danielzhang122/quadruped-robot/cad/quadruped-v1-urdf-source.png

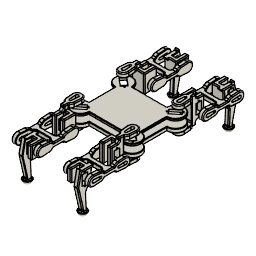
cad/quadruped-v1-urdf-source.png
