danielzhang122/quadruped-robot/description/meshes/bl_end.stl

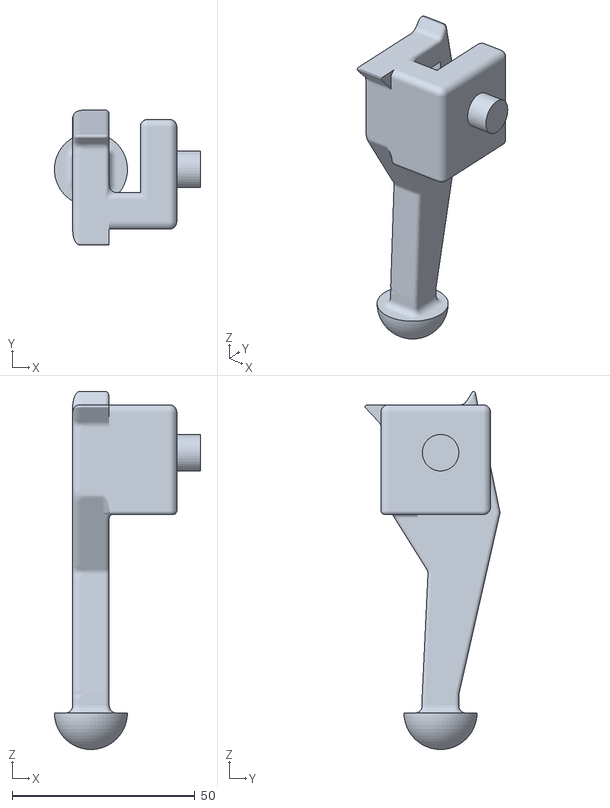
[picture p4: CAD file, 2026-11-11]
description/meshes/bl_end.stl
40.0 x 36.9 x 98.0
