danielzhang122/quadruped-robot/description/meshes/br_mid.stl

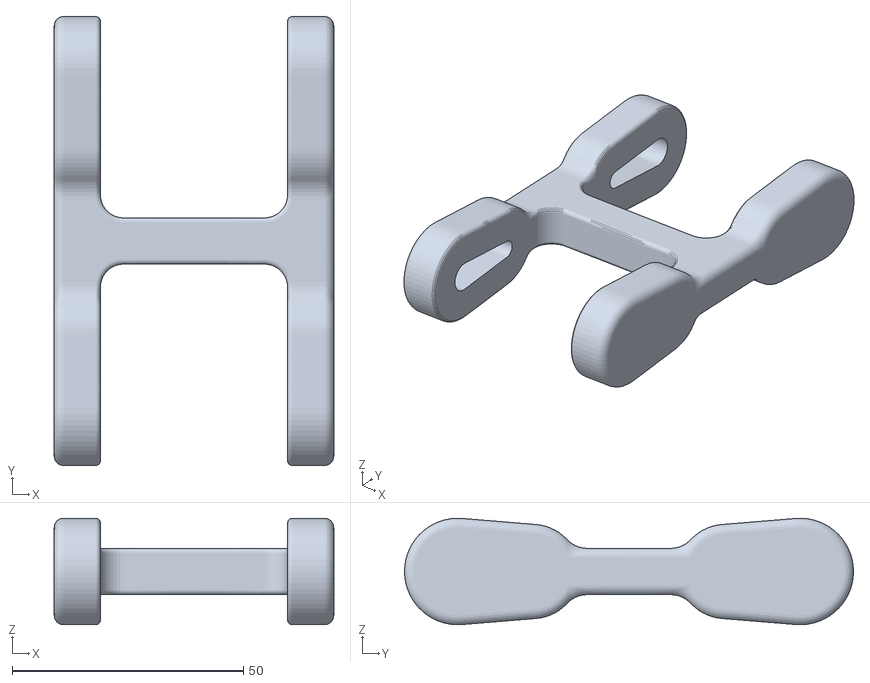
[picture p5: CAD file, 2026-11-11]
description/meshes/br_mid.stl
60.5 x 97.2 x 23.0
