danielzhang122/quadruped-robot/description/meshes/base_link.stl

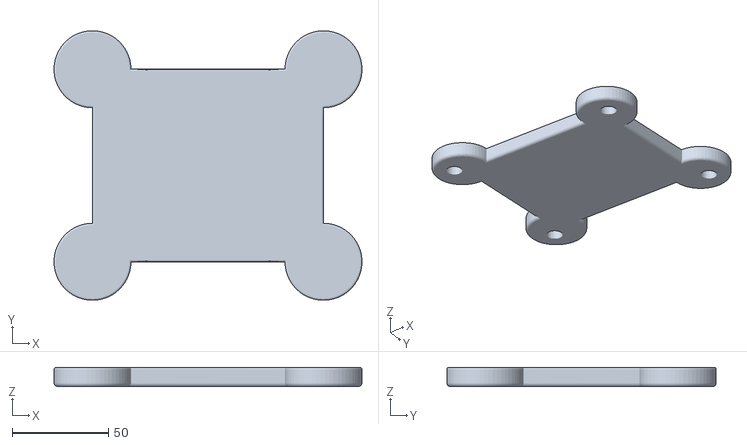
[picture p6: CAD file, 2026-11-11]
description/meshes/base_link.stl
160.0 x 140.0 x 10.0
