danielzhang122/quadruped-robot/description/meshes/fl_hip.stl

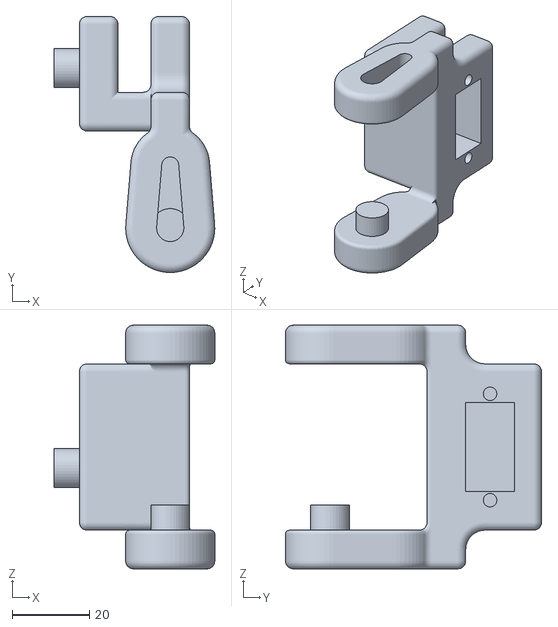
[picture p7: CAD file, 2026-11-11]
description/meshes/fl_hip.stl
41.5 x 66.2 x 63.0
