danielzhang122/quadruped-robot/description/meshes/base_upper.stl

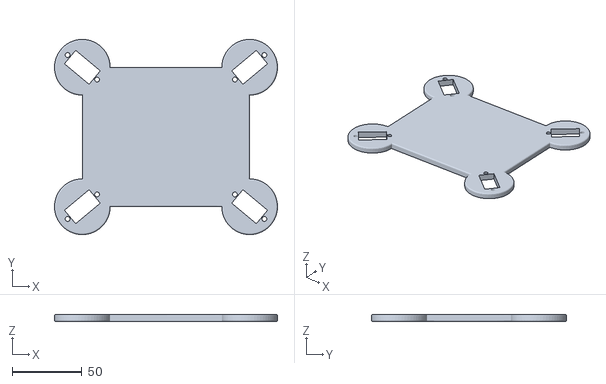
[picture p8: CAD file, 2026-11-11]
description/meshes/base_upper.stl
160.0 x 140.0 x 5.00
