danielzhang122/quadruped-robot/(list of files, cad)

Other CAD files:
description/meshes/fr_end.stl
description/meshes/fl_mid.stl
description/meshes/br_hip.stl
description/meshes/bl_hip.stl
description/meshes/br_end.stl
description/meshes/fr_mid.stl
description/meshes/fl_end.stl
description/meshes/fr_hip.stl
description/meshes/bl_mid.stl
cad/quadruped-v1-urdf-source.f3d
cad/quadruped-v2-may-2026.f3z
