danielzhang122/quadruped-robot/mujoco/robot.xml

<mujoco model="quadruped">
  <compiler angle="radian" meshdir="../description/meshes"/>

  <option gravity="0 0 -9.81" timestep="0.002"/>

  <default>
    <joint damping="1.5" frictionloss="0.2"/>
  </default>

  <asset>
    <mesh name="base_link" content_type="model/stl" file="base_link.stl" scale="0.001 0.001 0.001"/>
    <mesh name="fr_hip" content_type="model/stl" file="fr_hip.stl" scale="0.001 0.001 0.001"/>
    <mesh name="fr_mid" content_type="model/stl" file="fr_mid.stl" scale="0.001 0.001 0.001"/>
    <mesh name="fr_end" content_type="model/stl" file="fr_end.stl" scale="0.001 0.001 0.001"/>
    <mesh name="br_hip" content_type="model/stl" file="br_hip.stl" scale="0.001 0.001 0.001"/>
    <mesh name="br_mid" content_type="model/stl" file="br_mid.stl" scale="0.001 0.001 0.001"/>
    <mesh name="br_end" content_type="model/stl" file="br_end.stl" scale="0.001 0.001 0.001"/>
    <mesh name="fl_hip" content_type="model/stl" file="fl_hip.stl" scale="0.001 0.001 0.001"/>
    <mesh name="fl_mid" content_type="model/stl" file="fl_mid.stl" scale="0.001 0.001 0.001"/>
    <mesh name="fl_end" content_type="model/stl" file="fl_end.stl" scale="0.001 0.001 0.001"/>
    <mesh name="bl_hip" content_type="model/stl" file="bl_hip.stl" scale="0.001 0.001 0.001"/>
    <mesh name="bl_mid" content_type="model/stl" file="bl_mid.stl" scale="0.001 0.001 0.001"/>
    <mesh name="bl_end" content_type="model/stl" file="bl_end.stl" scale="0.001 0.001 0.001"/>
    <mesh name="base_upper" content_type="model/stl" file="base_upper.stl" scale="0.001 0.001 0.001"/>
  </asset>

  <worldbody>
    <light diffuse=".5 .5 .5" pos="0 0 3" dir="0 0 -1"/>
    <geom name="ground" type="plane" size="10 10 0.1" rgba="0.8 0.8 0.8 1"/>

    <body name="base_link" pos="0 0 0.15">
      <freejoint name="root"/>
      <geom type="mesh" mesh="base_link"/>
      <geom type="mesh" mesh="base_upper"/>

      <body name="fr_hip" pos="0.065762 -0.05514 -0.038083">
        <inertial pos="-0.00668492 -0.0276808 0.0119461" quat="0.965743 0.207359 -0.0300658 -0.153095" mass="0.0441843" diaginertia="2.99304e-05 1.92258e-05 1.66333e-05"/>
        <joint name="frontRightHip" pos="0 0 0" axis="0 0 -1" range="-2.35619 0.785398" actuatorfrcrange="-100 100"/>
        <geom pos="-0.065762 0.05514 0.038083" type="mesh" mesh="fr_hip"/>
        <body name="fr_mid" pos="-0.03 -0.041341 0.00755">
          <inertial pos="0.0243043 -0.0370653 -3.7597e-07" quat="0.5 0.5 -0.5 0.5" mass="0.0356783" diaginertia="4.69872e-05 2.72823e-05 2.18994e-05"/>
          <joint name="frontRightMid" pos="0 0 0" axis="-1 0 0" range="-1.5708 1.5708" actuatorfrcrange="-100 100"/>
          <geom pos="-0.035762 0.096481 0.030533" type="mesh" mesh="fr_mid"/>
          <body name="fr_end" pos="-0.002 -0.074131 0">
            <inertial pos="0.0248621 0.00119021 -0.0180069" quat="0.994646 -0.0397935 -0.0924563 0.0233996" mass="0.0299344" diaginertia="2.27975e-05 2.27196e-05 3.89009e-06"/>
            <joint name="frontRightEnd" pos="0 0 0" axis="1 0 0" range="-3.14159 0" actuatorfrcrange="-100 100"/>
            <geom pos="-0.033762 0.170612 0.030533" type="mesh" mesh="fr_end"/>
          </body>
        </body>
      </body>

      <body name="br_hip" pos="-0.062496 -0.05514 -0.038083">
        <inertial pos="0.00668428 -0.0276808 0.0119461" quat="0.965744 0.207356 0.0300641 0.153096" mass="0.0441844" diaginertia="2.99305e-05 1.92258e-05 1.66333e-05"/>
        <joint name="backRightHip" pos="0 0 0" axis="0 0 -1" range="-0.785398 2.35619" actuatorfrcrange="-100 100"/>
        <geom pos="0.062496 0.05514 0.038083" type="mesh" mesh="br_hip"/>
        <body name="br_mid" pos="0.03 -0.041341 0.00755">
          <inertial pos="-0.024305 -0.0370653 -3.75428e-07" quat="0.5 0.5 -0.5 0.5" mass="0.0356783" diaginertia="4.69872e-05 2.72823e-05 2.18995e-05"/>
          <joint name="backRightMid" pos="0 0 0" axis="1 0 0" range="-1.5708 1.5708" actuatorfrcrange="-100 100"/>
          <geom pos="0.032496 0.096481 0.030533" type="mesh" mesh="br_mid"/>
          <body name="br_end" pos="0.002 -0.074131 0">
            <inertial pos="-0.0248627 0.00119021 -0.0180069" quat="0.994646 -0.0397935 0.0924563 -0.0233996" mass="0.0299344" diaginertia="2.27975e-05 2.27196e-05 3.89009e-06"/>
            <joint name="backRightEnd" pos="0 0 0" axis="-1 0 0" range="0 3.14159" actuatorfrcrange="-100 100"/>
            <geom pos="0.030496 0.170612 0.030533" type="mesh" mesh="br_end"/>
          </body>
        </body>
      </body>

      <body name="fl_hip" pos="0.065762 0.051742 -0.038083">
        <inertial pos="-0.0066849 0.02768 0.0119461" quat="0.965744 -0.207356 -0.0300641 0.153096" mass="0.0441844" diaginertia="2.99305e-05 1.92258e-05 1.66333e-05"/>
        <joint name="frontLeftHip" pos="0 0 0" axis="0 0 -1" range="-0.785398 2.35619" actuatorfrcrange="-100 100"/>
        <geom pos="-0.065762 -0.051742 0.038083" type="mesh" mesh="fl_hip"/>
        <body name="fl_mid" pos="-0.03 0.04134 0.00755">
          <inertial pos="0.0243043 0.0370655 -3.75428e-07" quat="0.5 0.5 -0.5 0.5" mass="0.0356783" diaginertia="4.69872e-05 2.72823e-05 2.18995e-05"/>
          <joint name="frontLeftMid" pos="0 0 0" axis="-1 0 0" range="-1.5708 1.5708" actuatorfrcrange="-100 100"/>
          <geom pos="-0.035762 -0.093082 0.030533" type="mesh" mesh="fl_mid"/>
          <body name="fl_end" pos="-0.002 0.074131 0">
            <inertial pos="0.0248621 -0.00118998 -0.0180069" quat="0.994646 0.0397935 -0.0924563 -0.0233996" mass="0.0299344" diaginertia="2.27975e-05 2.27196e-05 3.89009e-06"/>
            <joint name="frontLeftEnd" pos="0 0 0" axis="1 0 0" range="0 3.14159" actuatorfrcrange="-100 100"/>
            <geom pos="-0.033762 -0.167213 0.030533" type="mesh" mesh="fl_end"/>
          </body>
        </body>
      </body>

      <body name="bl_hip" pos="-0.062496 0.051742 -0.038083">
        <inertial pos="0.00668431 0.02768 0.0119461" quat="0.965743 -0.207359 0.0300658 -0.153095" mass="0.0441843" diaginertia="2.99304e-05 1.92258e-05 1.66333e-05"/>
        <joint name="backLeftHip" pos="0 0 0" axis="0 0 -1" range="-2.35619 0.785398" actuatorfrcrange="-100 100"/>
        <geom pos="0.062496 -0.051742 0.038083" type="mesh" mesh="bl_hip"/>
        <body name="bl_mid" pos="0.03 0.04134 0.00755">
          <inertial pos="-0.024305 0.0370655 -3.7597e-07" quat="0.5 0.5 -0.5 0.5" mass="0.0356783" diaginertia="4.69872e-05 2.72823e-05 2.18994e-05"/>
          <joint name="backLeftMid" pos="0 0 0" axis="1 0 0" range="-1.5708 1.5708" actuatorfrcrange="-100 100"/>
          <geom pos="0.032496 -0.093082 0.030533" type="mesh" mesh="bl_mid"/>
          <body name="bl_end" pos="0.002 0.074131 0">
            <inertial pos="-0.0248627 -0.00118998 -0.0180069" quat="0.994646 0.0397935 0.0924563 0.0233996" mass="0.0299344" diaginertia="2.27975e-05 2.27196e-05 3.89009e-06"/>
            <joint name="backLeftEnd" pos="0 0 0" axis="-1 0 0" range="-3.14159 0" actuatorfrcrange="-100 100"/>
            <geom pos="0.030496 -0.167213 0.030533" type="mesh" mesh="bl_end"/>
          </body>
        </body>
      </body>

    </body>
  </worldbody>

  <actuator>
    <position name="frontRightHip" joint="frontRightHip" kp="100" ctrlrange="-2.356 0.785"/>
    <position name="frontRightMid" joint="frontRightMid" kp="100" ctrlrange="-1.571 1.571"/>
    <position name="frontRightEnd" joint="frontRightEnd" kp="100" ctrlrange="-3.142 0.0"/>
    <position name="backRightHip" joint="backRightHip" kp="100" ctrlrange="-0.785 2.356"/>
    <position name="backRightMid" joint="backRightMid" kp="100" ctrlrange="-1.571 1.571"/>
    <position name="backRightEnd" joint="backRightEnd" kp="100" ctrlrange="0.0 3.142"/>
    <position name="frontLeftHip" joint="frontLeftHip" kp="100" ctrlrange="-0.785 2.356"/>
    <position name="frontLeftMid" joint="frontLeftMid" kp="100" ctrlrange="-1.571 1.571"/>
    <position name="frontLeftEnd" joint="frontLeftEnd" kp="100" ctrlrange="0.0 3.142"/>
    <position name="backLeftHip" joint="backLeftHip" kp="100" ctrlrange="-2.356 0.785"/>
    <position name="backLeftMid" joint="backLeftMid" kp="100" ctrlrange="-1.571 1.571"/>
    <position name="backLeftEnd" joint="backLeftEnd" kp="100" ctrlrange="-3.142 0.0"/>
  </actuator>

</mujoco>
