danielzhang122/quadruped-robot/pcb/quadped.kicad_pcb

## KiCad design pcb/quadped.kicad_pcb (2026-11-12)

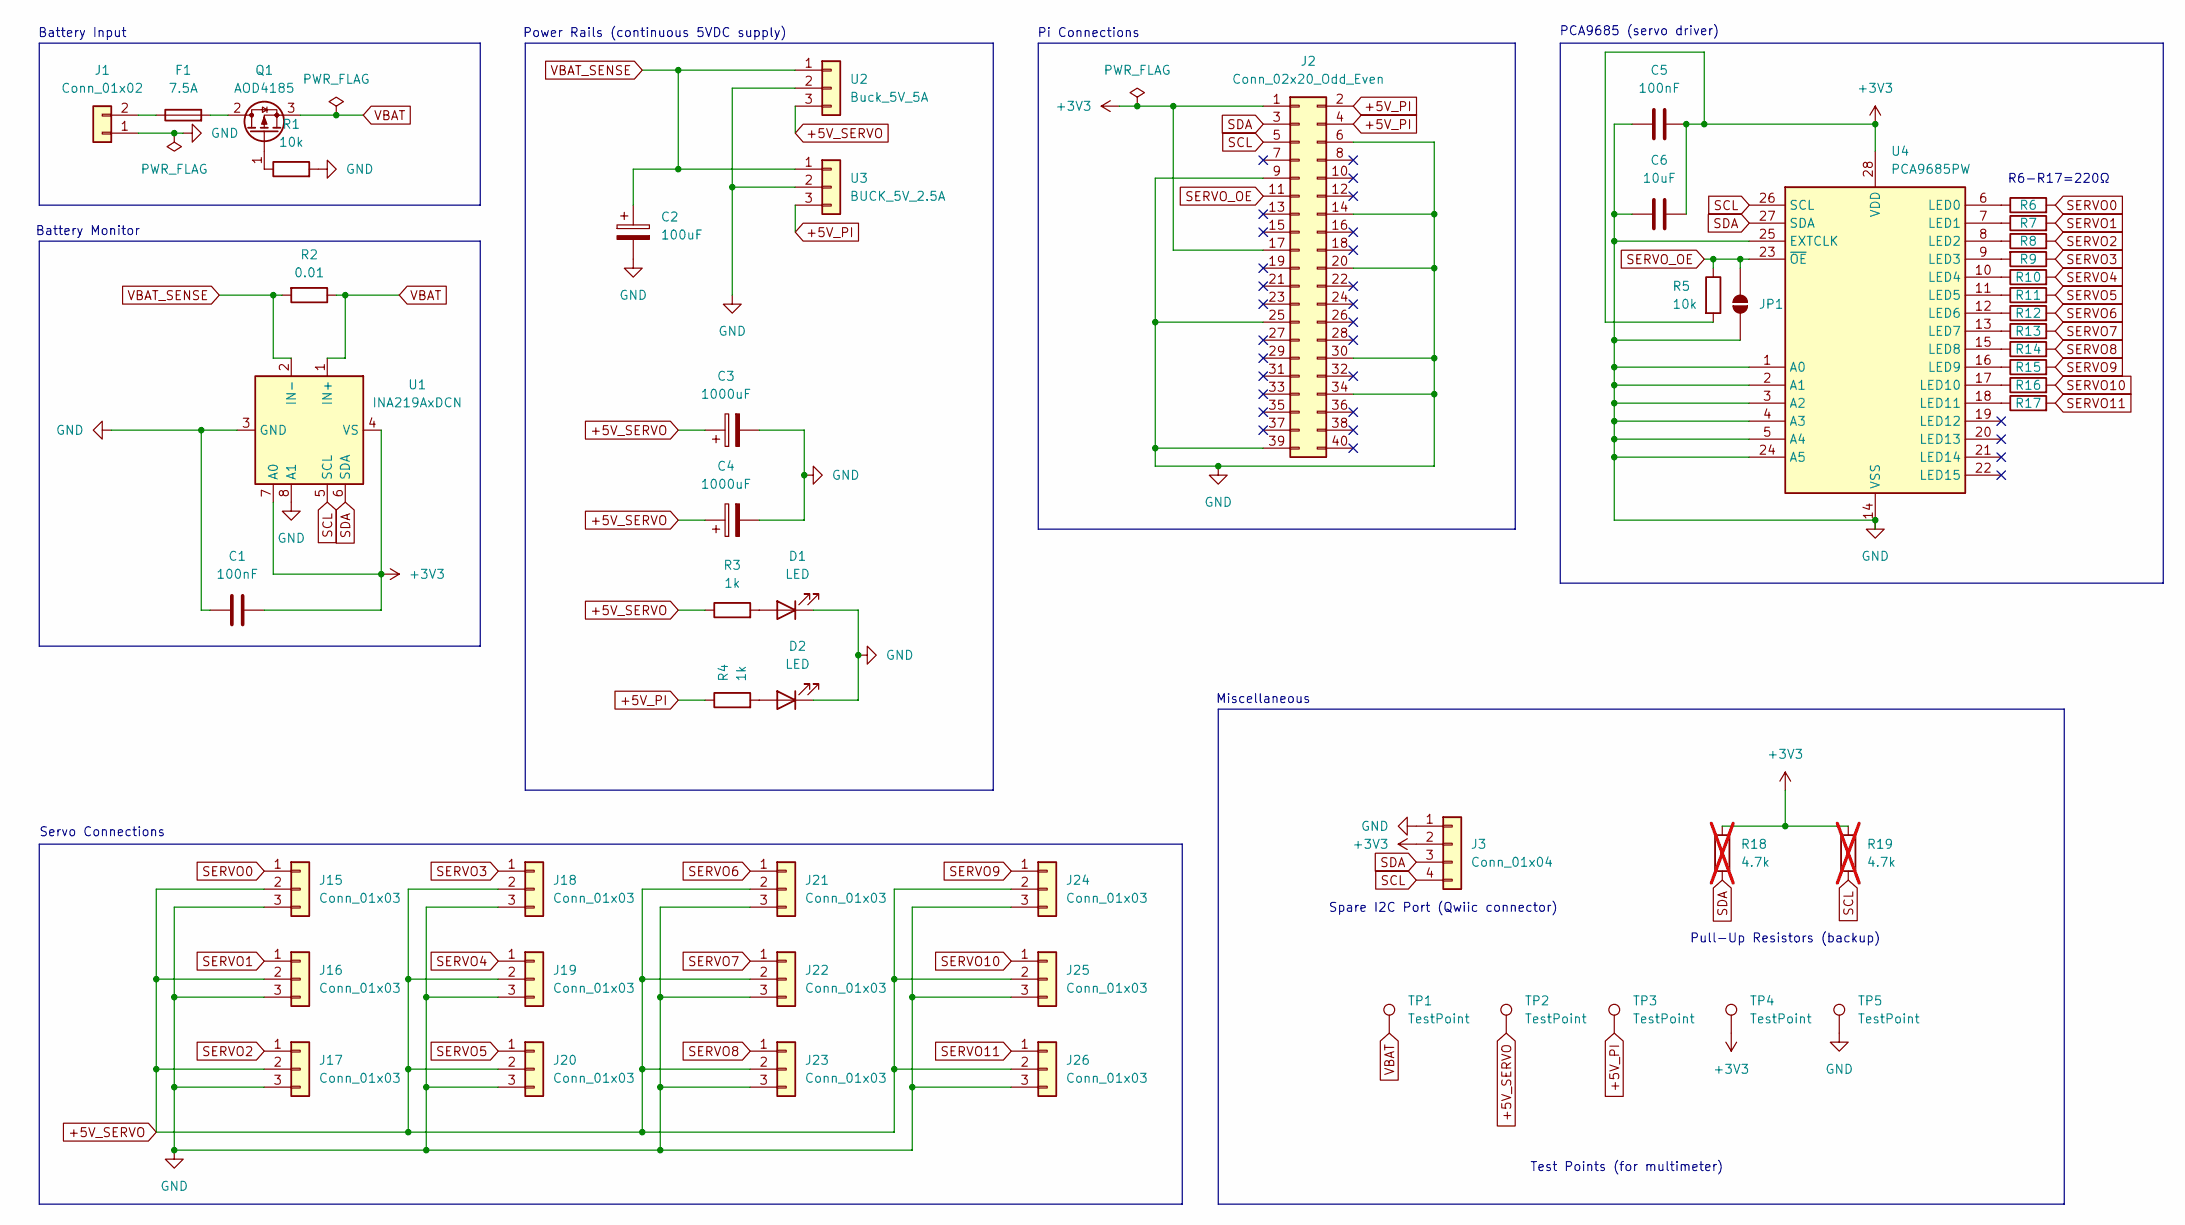
[picture p9: schematic quadped.kicad_sch, Main PCB]

Parts:
C1, C5: 100nF; C_0805_2012Metric
C2: 100uF; CP_Radial_D6.3mm_P2.50mm
C3, C4: 1000uF; CP_Radial_D10.0mm_P5.00mm
C6: 10uF; C_0805_2012Metric
D1, D2: LED; LED_0805_2012Metric
F1: 7.5A; Fuseholder_Blade_Mini_Keystone_3568
J1: Conn_01x02; AMASS_XT30PW-M_1x02_P2.50mm_Horizontal
J2: Conn_02x20_Odd_Even; PinHeader_2x20_P2.54mm_Vertical
J3: Conn_01x04; JST_SH_SM04B-SRSS-TB_1x04-1MP_P1.00mm_Horizontal
J15, J16, J17, J18, J19, J20, J21, J22, J23, J24, J25, J26: Conn_01x03; PinHeader_1x03_P2.54mm_Vertical
JP1: BYPASS; SolderJumper-2_P1.3mm_Open_Pad1.0x1.5mm
Q1: AOD4185; TO-252-2
R1, R5: 10k; R_0805_2012Metric
R2: 0.01; R_2512_6332Metric
R3, R4: 1k; R_0805_2012Metric
R6, R7, R8, R9, R10, R11, R12, R13, R14, R15, R16, R17: 220; R_0805_2012Metric
R18, R19: 4.7k; R_0805_2012Metric; not fitted
TP1, TP2, TP3, TP4, TP5: TestPoint; TestPoint_Pad_D1.5mm
U1: INA219AxDCN; SOT-23-8
U2: Buck_5V_5A; PinHeader_1x03_P2.54mm_Vertical
U3: BUCK_5V_2.5A; PinHeader_1x03_P2.54mm_Vertical
U4: PCA9685PW; TSSOP-28_4.4x9.7mm_P0.65mm

Connections:
+3V3: C1.2, C5.2, C6.2, J2.1, J2.17, J3.2, R5.2, R18.2, R19.1, TP4.1 (1_1), U1.4 (VS), U1.7 (A0), U4.28 (VDD)
+5V_PI: J2.2, J2.4, R4.1, TP3.1 (1_1), U3.3
+5V_SERVO: C3.1, C4.1, J15.2, J16.2, J17.2, J18.2, J19.2, J20.2, J21.2, J22.2, J23.2, J24.2, J25.2, J26.2, R3.1, TP2.1 (1_1), U2.3
GND: C1.1, C2.2, C3.2, C4.2, C5.1, C6.1, D1.1 (K), D2.1 (K), J1.1, J2.6, J2.9, J2.14, J2.20, J2.25, J2.30, J2.34, J2.39, J3.1, J15.3, J16.3, J17.3, J18.3, J19.3, J20.3, J21.3, J22.3, J23.3, J24.3, J25.3, J26.3, JP1.1 (A), R1.2, TP5.1 (1_1), U1.3 (GND), U1.8 (A1), U2.2, U3.2, U4.1 (A0), U4.2 (A1), U4.3 (A2), U4.4 (A3), U4.5 (A4), U4.14 (VSS), U4.24 (A5), U4.25 (EXTCLK)
unnamed: D1.2 (A), R3.2
unnamed: D2.2 (A), R4.2
unnamed: F1.1, J1.2
unnamed: F1.2, Q1.2 (D)
unnamed: Q1.1 (G), R1.1
unnamed: R6.1, U4.6 (LED0)
unnamed: R7.1, U4.7 (LED1)
unnamed: R8.1, U4.8 (LED2)
unnamed: R9.2, U4.9 (LED3)
unnamed: R10.1, U4.10 (LED4)
unnamed: R11.1, U4.11 (LED5)
unnamed: R12.1, U4.12 (LED6)
unnamed: R13.1, U4.13 (LED7)
unnamed: R14.1, U4.15 (LED8)
unnamed: R15.1, U4.16 (LED9)
unnamed: R16.1, U4.17 (LED10)
unnamed: R17.1, U4.18 (LED11)
SCL: J2.5, J3.4, R19.2, U1.5 (SCL), U4.26 (SCL)
SDA: J2.3, J3.3, R18.1, U1.6 (SDA), U4.27 (SDA)
SERVO0: J15.1, R6.2
SERVO1: J16.1, R7.2
SERVO2: J17.1, R8.2
SERVO3: J18.1, R9.1
SERVO4: J19.1, R10.2
SERVO5: J20.1, R11.2
SERVO6: J21.1, R12.2
SERVO7: J22.1, R13.2
SERVO8: J23.1, R14.2
SERVO9: J24.1, R15.2
SERVO10: J25.1, R16.2
SERVO11: J26.1, R17.2
SERVO_OE: J2.11, JP1.2 (B), R5.1, U4.23 (~OE)
VBAT: Q1.3 (S), R2.1, TP1.1 (1_1), U1.1 (IN+)
VBAT_SENSE: C2.1, R2.2, U1.2 (IN-), U2.1, U3.1

Notes on the sheet:
PCA9685 (servo driver)
Pi Connections
Battery Input
Test Points (for multimeter)
Spare I2C Port (Qwiic connector)
Power Rails (continuous 5VDC supply)
R6-R17=220Ω
Battery Monitor
Miscellaneous
Pull-Up Resistors (backup)
Servo Connections

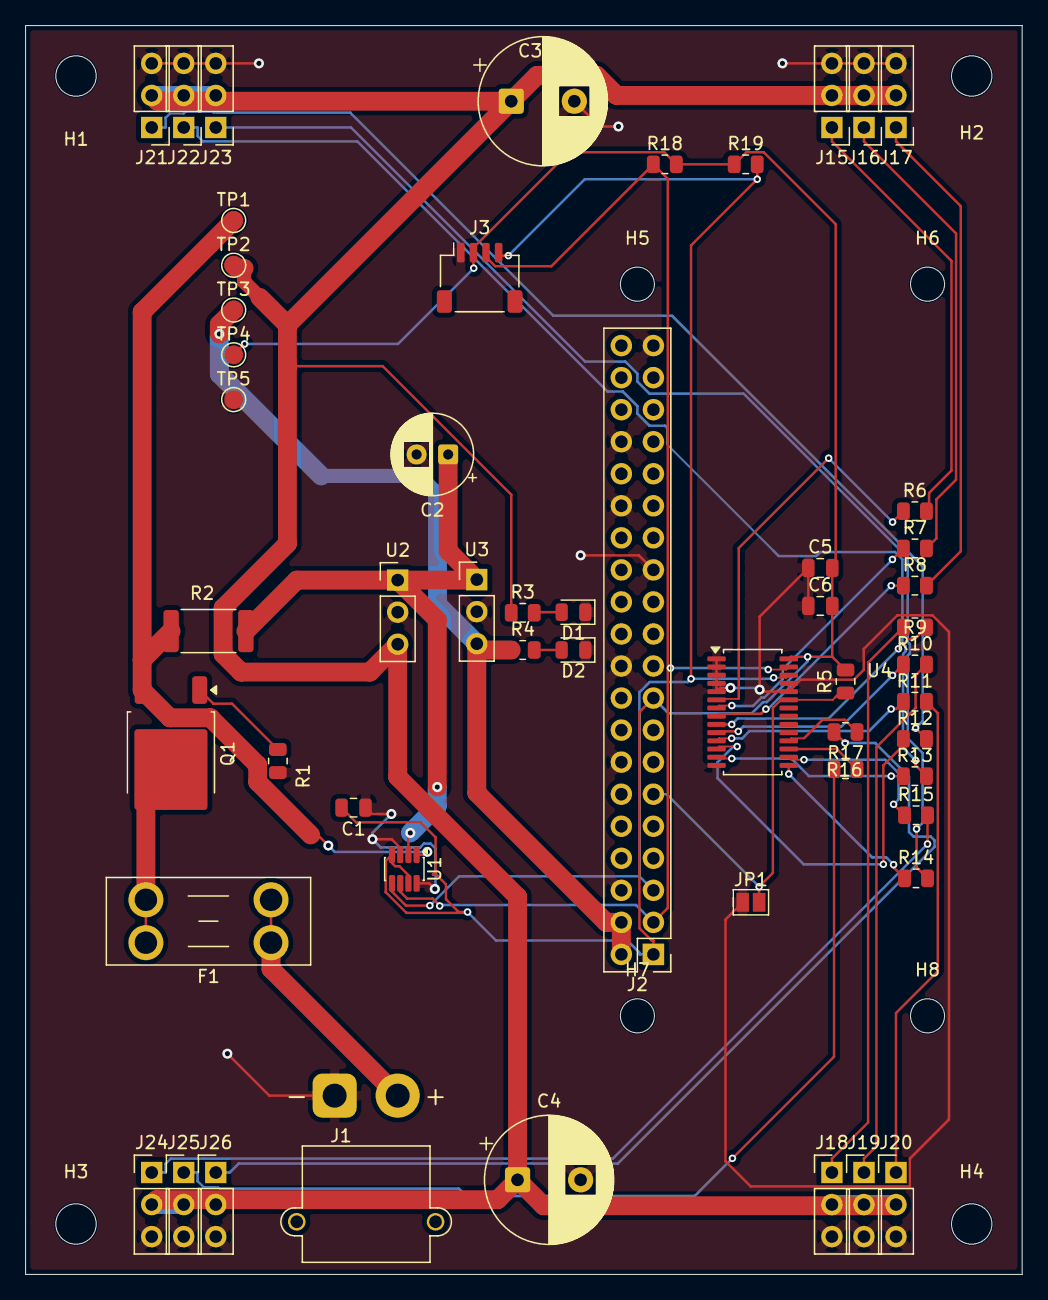
[picture p10: board quadped.kicad_pcb from above]

Board: 2 copper layers, 79.0 x 99.0 mm, 62 parts (0 on the bottom side), 38 nets.

Other parts of the board:
H1, H2, H3, H4: MountingHole_3.2mm_M3
H5, H6, H7, H8: MountingHole_2.7mm_M2.5
