danielzhang122/quadruped-robot/(commit log)

2026-11-11 Initial commit: quadruped trot controller, MuJoCo model, URDF and CAD
    - Trot gait controller (sim + PCA9685 hardware) with fixed joint frame,
    working --hardware flag, and I2C write deadband on hardware
    - MuJoCo model, ROS 2 quadruped_description package, STL meshes renamed
    to a consistent <leg>_<segment> scheme
    - CAD: v2 (May 2026, latest, .f3z) and v1 (URDF source)
    - Unit, hardware-mapping and headless sim tests
    [base_link.stl, base_upper.stl, bl_end.stl, bl_hip.stl, bl_mid.stl, br_end.stl, br_hip.stl, br_mid.stl]
2026-11-11 Document hardware readiness, CAD components, and portfolio link
2026-11-11 Add PCB plan and KiCad guide
    Covers the board's circuit (battery input, two 5 V rails, PCA9685, INA219, Pi header, servo headers), KiCad workflow, BOM and bring-up.
2026-11-11 Add full PCB component list, net names and board layout
2026-11-11 Explain each PCB section and part in the README
2026-11-11 Match J1 pinout to schematic (pin 1 = +)
2026-11-11 Explain I2C addresses in PCB section 2
2026-11-11 Clarify INA219 address is picked by A0/A1 wiring
2026-11-11 Explain footprints and match part refs to schematic
2026-11-11 Add KiCad project: complete schematic with footprints
    [quadped.kicad_pcb, quadped.kicad_sch]
2026-11-11 Match J1 pinout to XT30 footprint (pin 2 = +)
2026-11-11 Move KiCad project files up into pcb/
    [quadped.kicad_pcb, quadped.kicad_sch]
2026-11-11 Update README with PCB progress
2026-11-11 PCB layout in progress: board setup, outline, parts on board
    [quadped.kicad_pcb, quadped.kicad_sch]
2026-11-12 PCB layout progress: routing and schematic updates
    [quadped.kicad_pcb, quadped.kicad_sch]
2026-11-12 PCB layout progress
    [quadped.kicad_pcb]
2026-11-12 Update READMEs: PCB design complete, layout notes, ordering steps
2026-11-12 Add PCB silkscreen polish to the to-do list
2026-11-12 Rewrite PCB README as a streamlined circuit overview
